Bedno/electronic_bike_bell/EBB-Schematic-v1.png

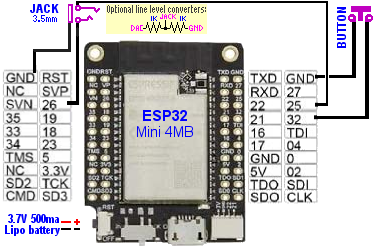
EBB-Schematic-v1.png
