Bedno/electronic_bike_bell/EBB-Assembled.jpg

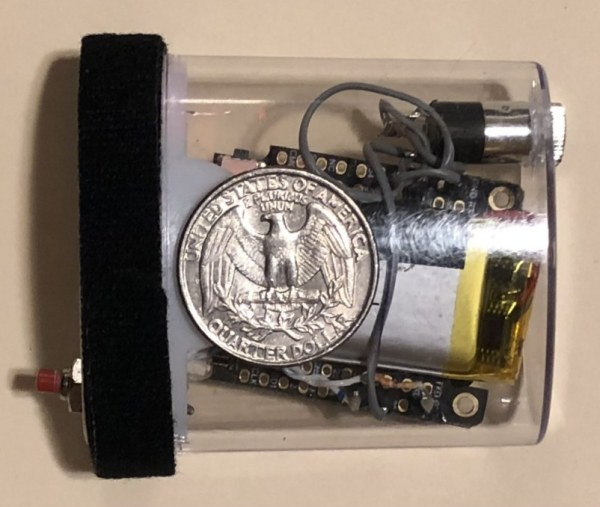
EBB-Assembled.jpg
