Bedno/electronic_bike_bell/(commit log)

2022-02-17 Electronic Bike Bell v1.1 first upload
    Electronic Bike Bell with 20 sounds. Built with an ESP32 microcontroller. Connects to a bike stereo. More info at https://bedno.com/ebb
2022-03-21 Updated schematic.
    Updated schematic changes the suggested optional line level conversion resistors to 1K/1K, should give outputs 0-1.8V but is untested.
2022-03-21 Improvements to skipping behavior.
    Skipping now pauses on the first sound (bike bell ring) to indicate when series restart.
    Volume is now reduced in advance of the first skip (first skip time /2) as that's usually the intent.
    Also a master volume divisor was added to try to create line level output (as opposed to 0-VDC) but too much quality is lost. It's disappointing that the DAC doesn't have built-in analog scaling. Relatedly the suggested optional line level conversion resistors on the schematic are updated to 1K/1K, should give outputs 0-1.8V but is untested.
    [EBB.ino]
2022-03-22 Minor edits
    Changed resistor values.
2022-03-22 Added battery life note (500mAh=15hrs)
    Added battery life note. Several readability edits.
